Miceuz/PlantWateringAlarm/pics/pile-o-chirps.png

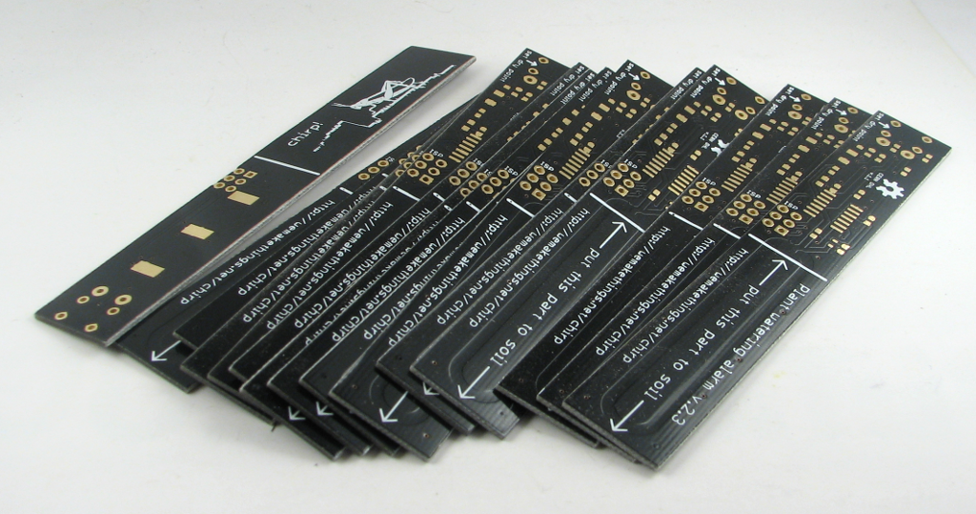
pics/pile-o-chirps.png
