Miceuz/PlantWateringAlarm/pics/IMG_9156.JPG

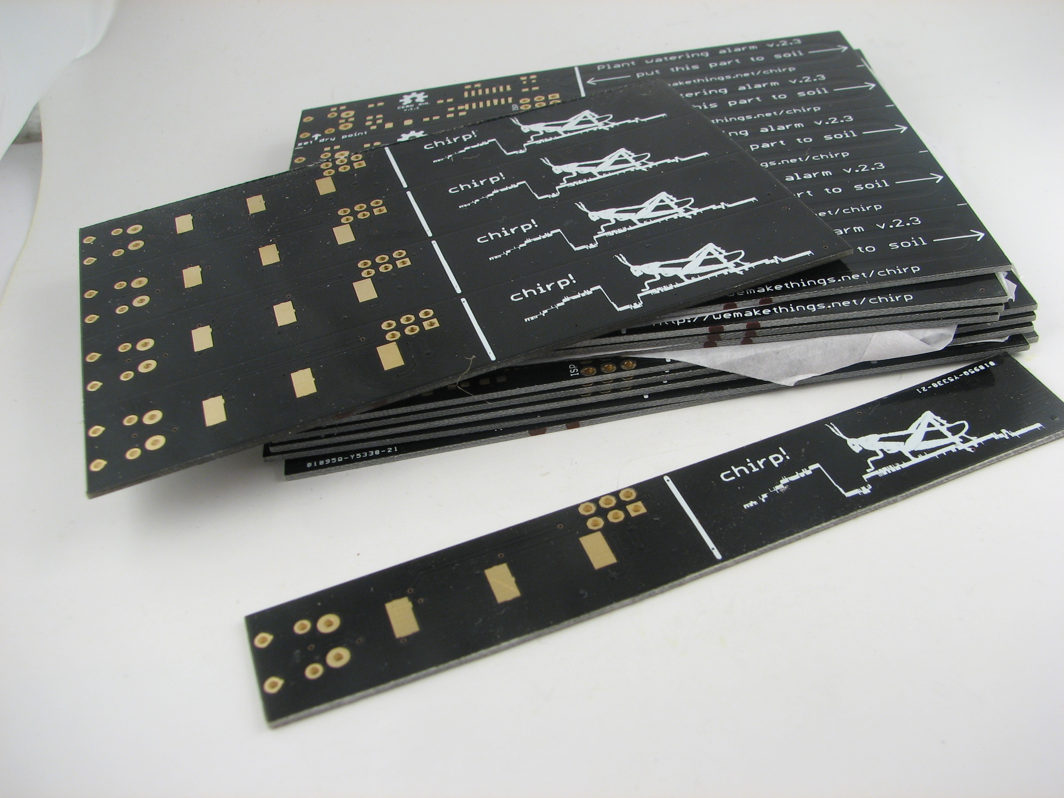
pics/IMG_9156.JPG
