Miceuz/PlantWateringAlarm/README.md

PlantWateringAlarm
==================

A soil moisture level sensor based on ATTINY44. Uses capacitive sensing.



More info at http://wemakethings.net/chirp

Contact: mic a wemakethings.net
