Miceuz/PlantWateringAlarm/chirp-mfg-2.4.4/chirp-schematics.png

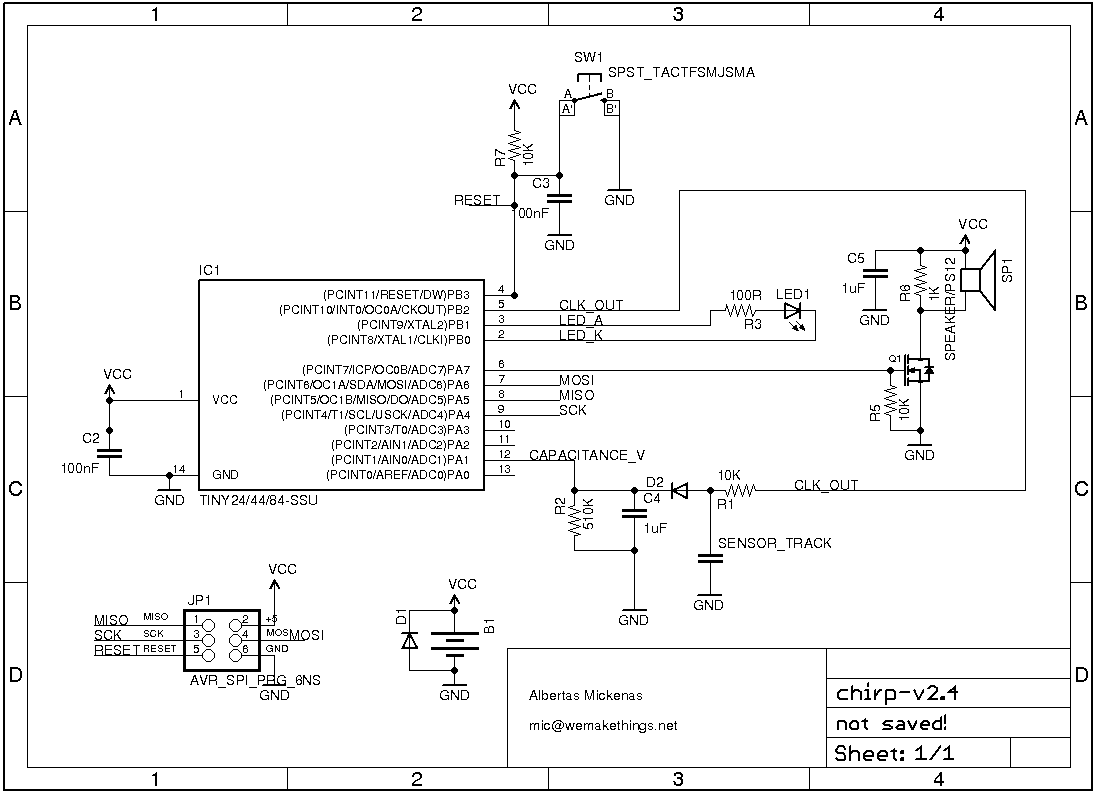
chirp-mfg-2.4.4/chirp-schematics.png
