Miceuz/PlantWateringAlarm/chirp-mfg-2.4.4/chirp-top.jpg

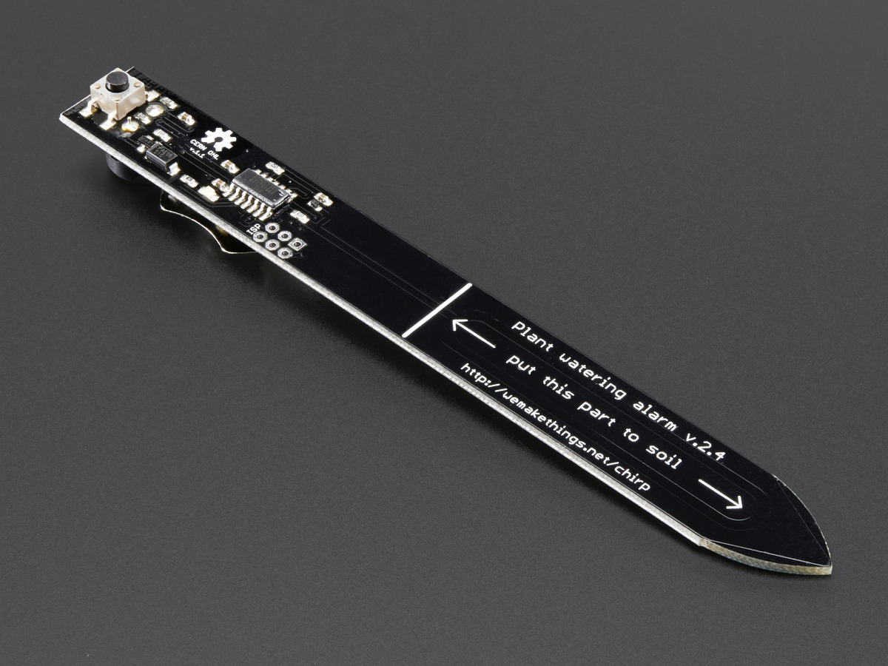
chirp-mfg-2.4.4/chirp-top.jpg
