Miceuz/PlantWateringAlarm/eagleUp/chirp-bot.png

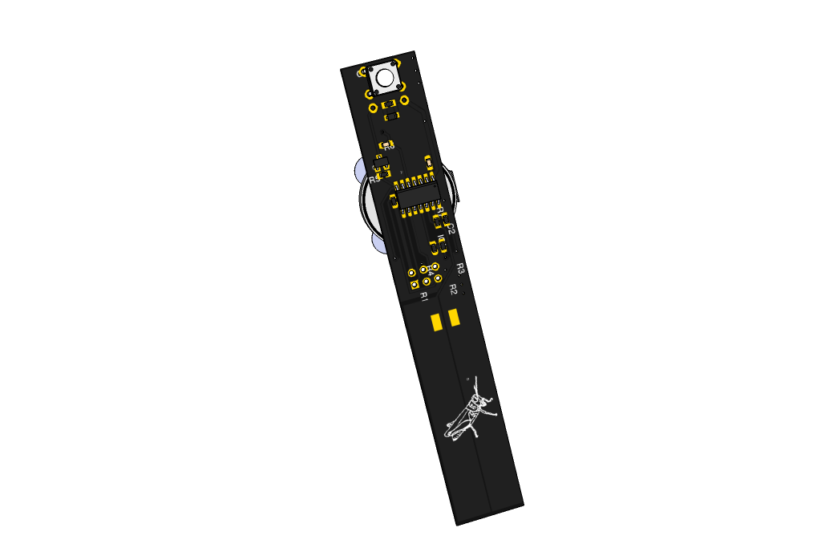
eagleUp/chirp-bot.png
