Miceuz/PlantWateringAlarm/eagleUp/chirp.png

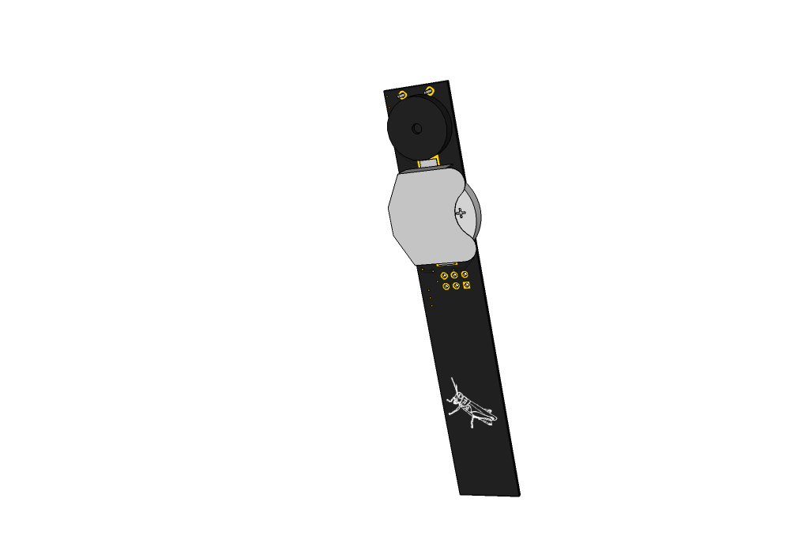
eagleUp/chirp.png
