Miceuz/PlantWateringAlarm/eagleUp/eagleUp_humidity-v2.1_bottom.png

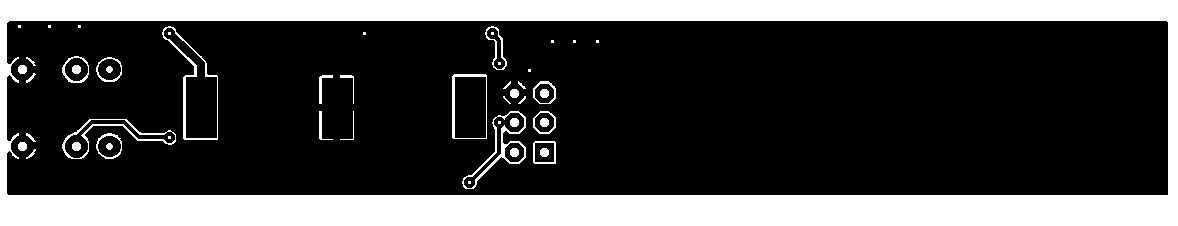
eagleUp/eagleUp_humidity-v2.1_bottom.png
