Miceuz/PlantWateringAlarm/eagleUp/eagleUp_humidity-v2.1_bottom_mask.png

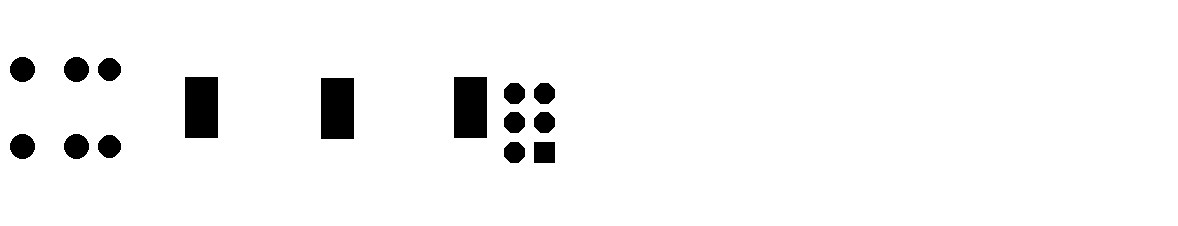
eagleUp/eagleUp_humidity-v2.1_bottom_mask.png
