Miceuz/PlantWateringAlarm/eagleUp/eagleUp_humidity-v2.1_bottom_silk.png

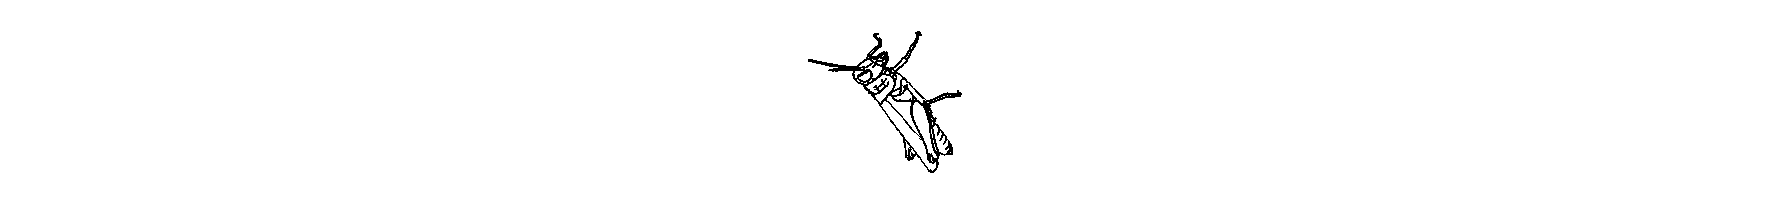
eagleUp/eagleUp_humidity-v2.1_bottom_silk.png
