Miceuz/PlantWateringAlarm/eagleUp/eagleUp_humidity-v2.1_imagesize.png

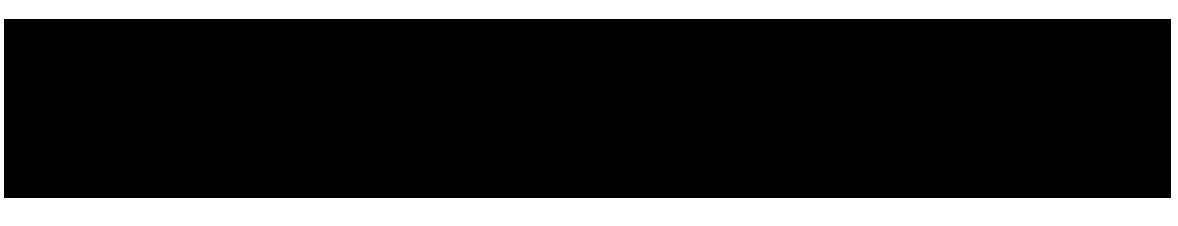
eagleUp/eagleUp_humidity-v2.1_imagesize.png
