Miceuz/PlantWateringAlarm/eagleUp/eagleUp_humidity-v2.1_outline.png

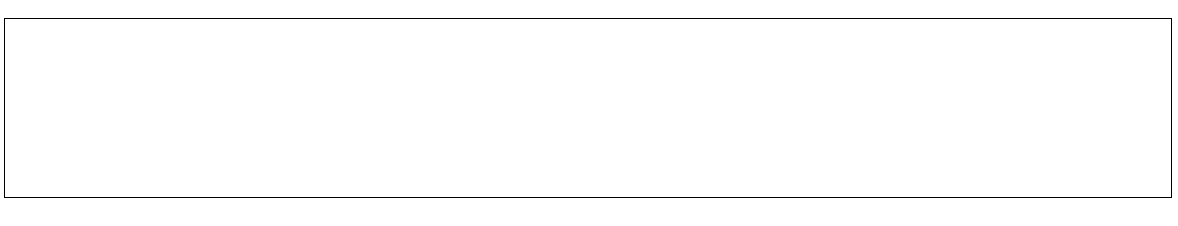
eagleUp/eagleUp_humidity-v2.1_outline.png
