Miceuz/PlantWateringAlarm/eagleUp/eagleUp_humidity-v2.1_top.png

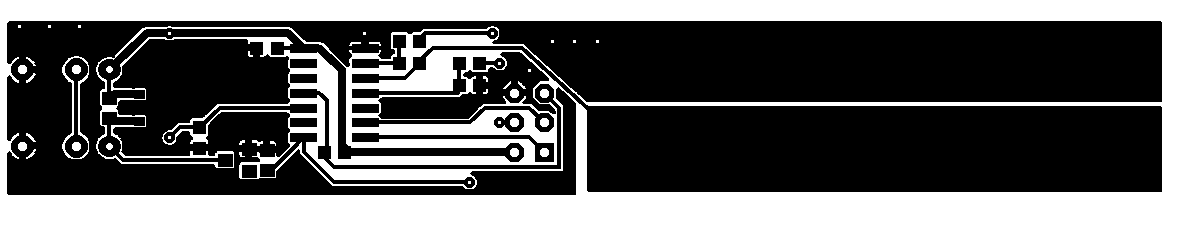
eagleUp/eagleUp_humidity-v2.1_top.png
