Miceuz/PlantWateringAlarm/eagleUp/eagleUp_humidity-v2.1_top_mask.png

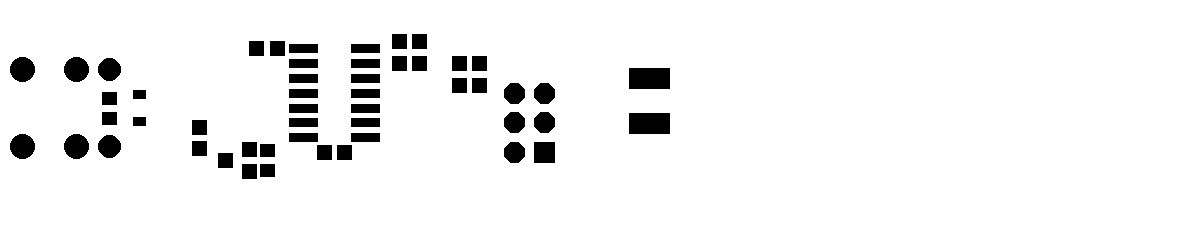
eagleUp/eagleUp_humidity-v2.1_top_mask.png
