Miceuz/PlantWateringAlarm/eagleUp/eagleUp_humidity-v2.1_top_silk.png

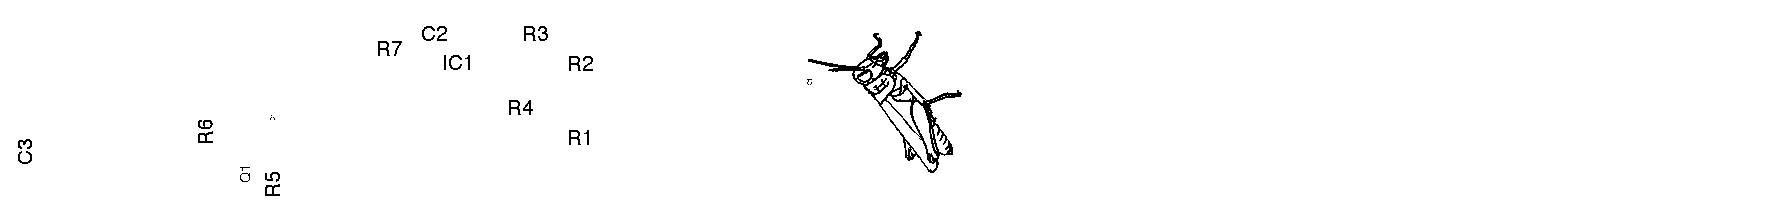
eagleUp/eagleUp_humidity-v2.1_top_silk.png
