Miceuz/PlantWateringAlarm/eagleUp/eagleUp_humidity-v2.3_bottom.png

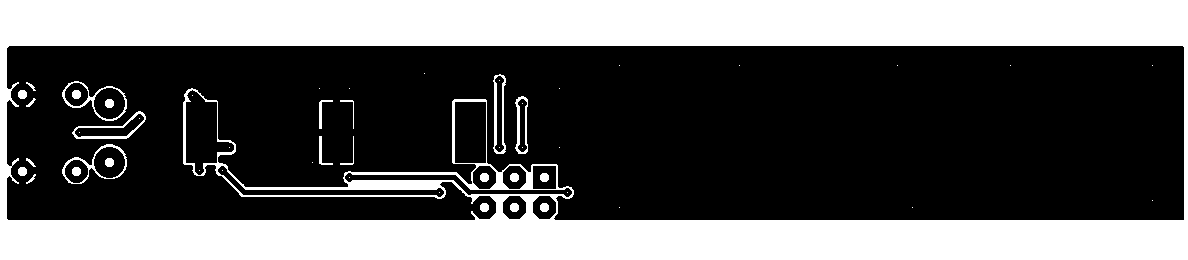
eagleUp/eagleUp_humidity-v2.3_bottom.png
