Miceuz/PlantWateringAlarm/eagleUp/eagleUp_humidity-v2.3_bottom_mask.png

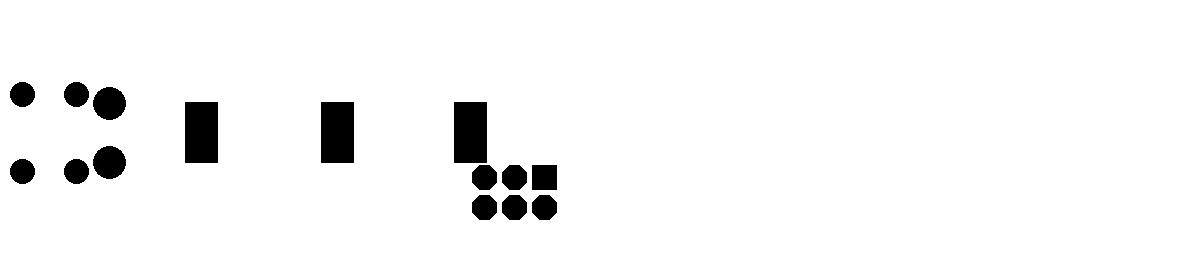
eagleUp/eagleUp_humidity-v2.3_bottom_mask.png
