Miceuz/PlantWateringAlarm/eagleUp/eagleUp_humidity-v2.3_bottom_silk.png

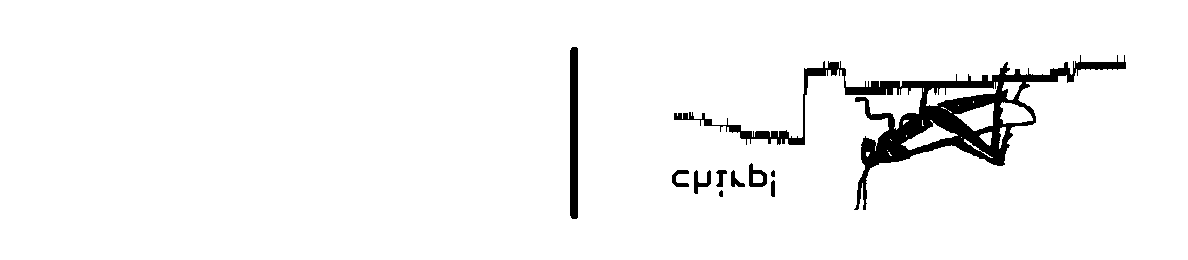
eagleUp/eagleUp_humidity-v2.3_bottom_silk.png
