Miceuz/PlantWateringAlarm/eagleUp/eagleUp_humidity-v2.3_top.png

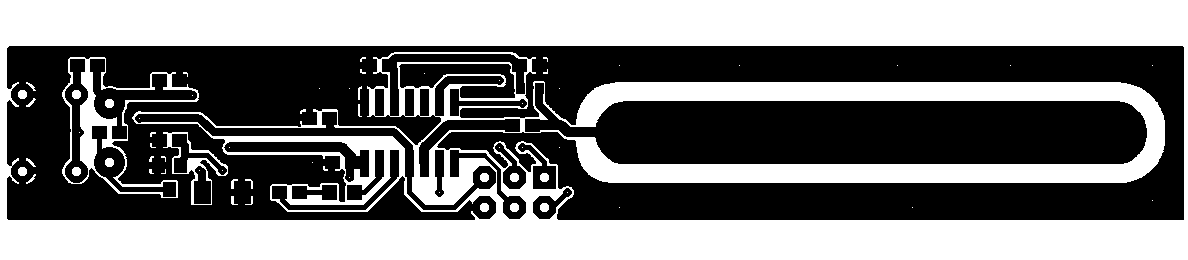
eagleUp/eagleUp_humidity-v2.3_top.png
