Miceuz/PlantWateringAlarm/eagleUp/eagleUp_humidity-v2.3_top_mask.png

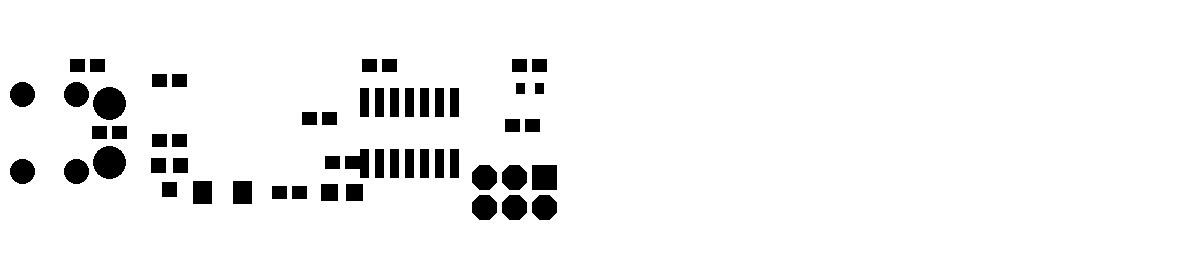
eagleUp/eagleUp_humidity-v2.3_top_mask.png
