Miceuz/PlantWateringAlarm/eagleUp/eagleUp_humidity-v2.3_top_silk.png

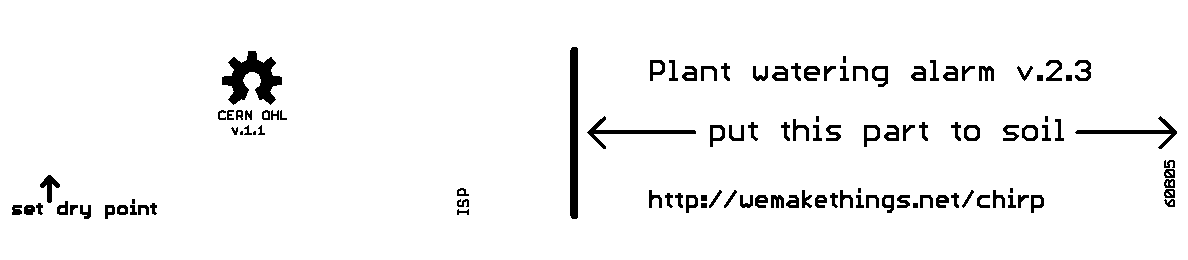
eagleUp/eagleUp_humidity-v2.3_top_silk.png
