Miceuz/PlantWateringAlarm/pics/chirp-boards.jpg

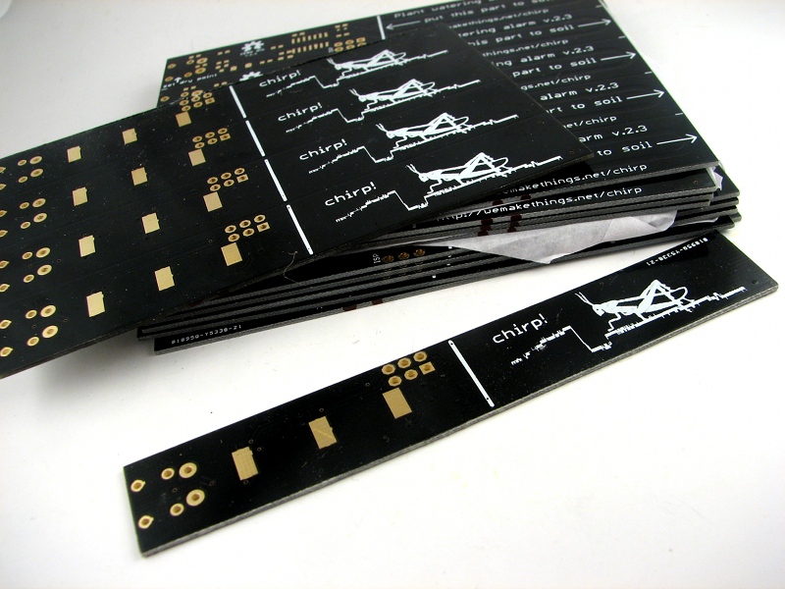
pics/chirp-boards.jpg
