Miceuz/PlantWateringAlarm/pics/IMG_9155.JPG

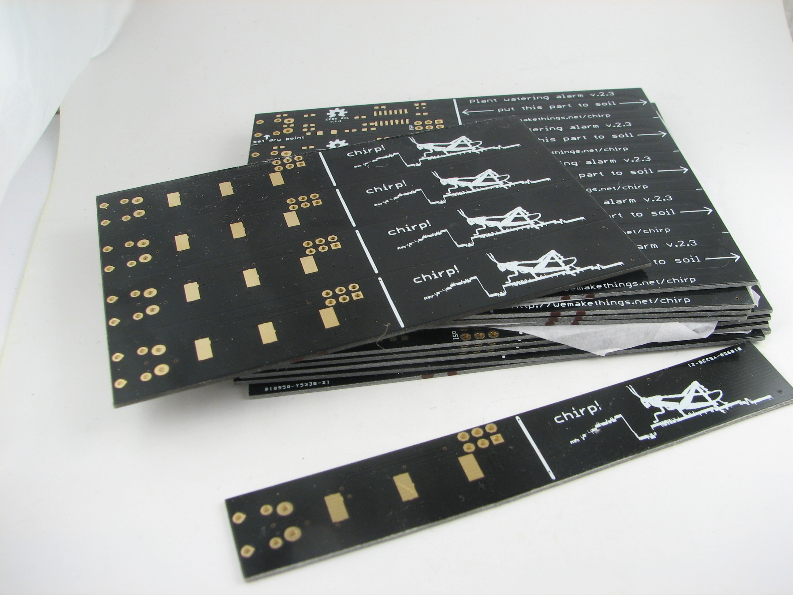
pics/IMG_9155.JPG
