Miceuz/PlantWateringAlarm/pics/IMG_9157.JPG

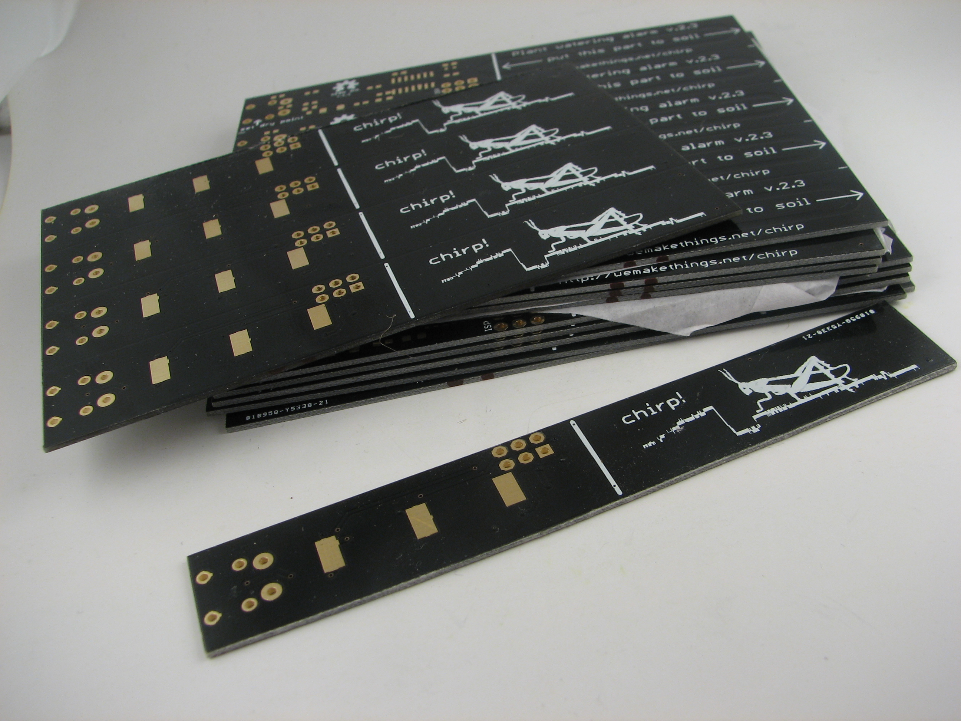
pics/IMG_9157.JPG
