Miceuz/PlantWateringAlarm/pics/sensor.jpg

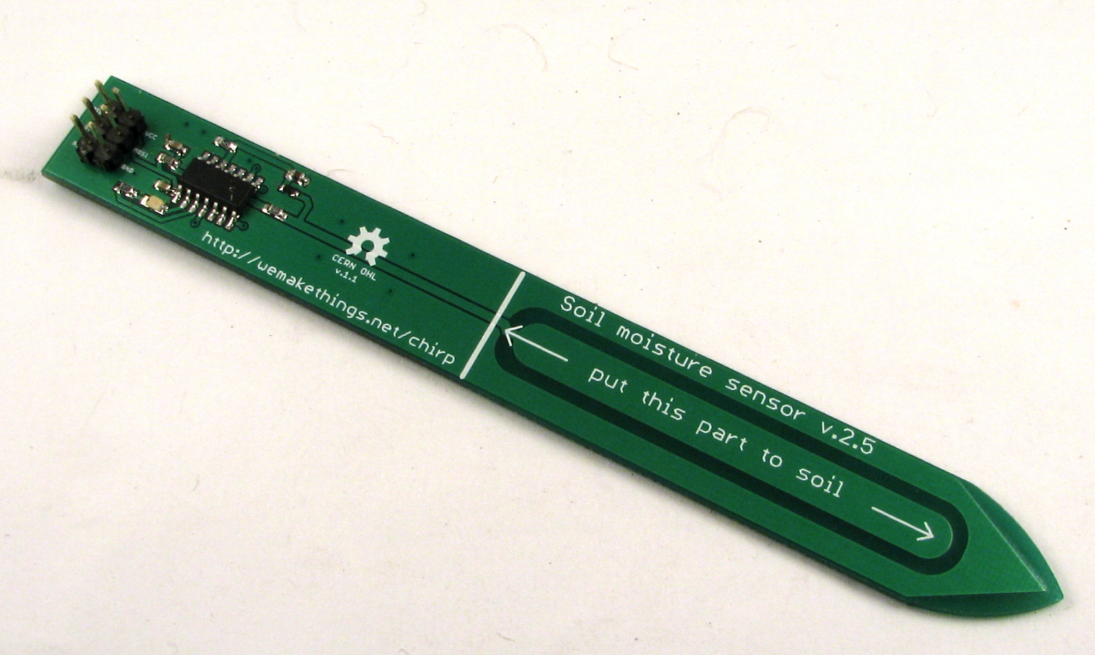
pics/sensor.jpg
