Miceuz/PlantWateringAlarm/(list of files, cad)

Other CAD files:
eagleUp/chirp v.2.3.skp
eagleUp/chirp.skp
eagleUp/chirp2.skp
eagleUp/humidity-v2.3.eup.skp
