Miceuz/PlantWateringAlarm/pics/measurements-moisture.png

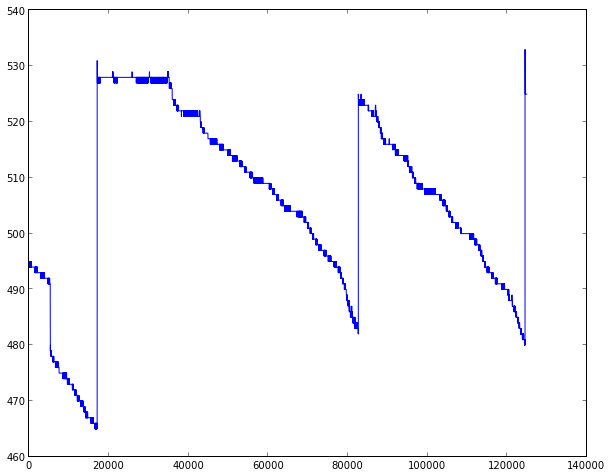
pics/measurements-moisture.png
