Miceuz/PlantWateringAlarm/pics/measurements.png

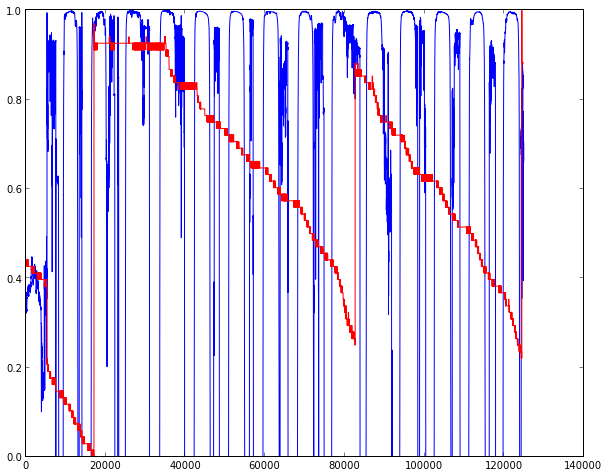
pics/measurements.png
