Miceuz/PlantWateringAlarm/tests/temp-drift.png

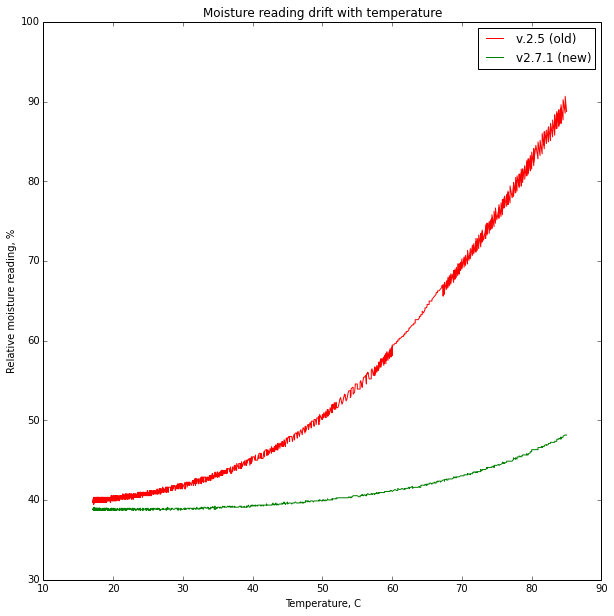
tests/temp-drift.png
