Miceuz/PlantWateringAlarm/(threads)

Thread 1 (2015-04-17):

No Part?

sabas1080, 2015-04-17:
Hi
What numer part is diode schottky, mofet N and "diode sod80c"?

Thanks

sabas1080, 2015-04-17:
I'm sorry and I saw bom.csv, thanks

Closed 2015-04-17.

Thread 3 (2017-02-27):

Operation with lithium cells

dewi-ny-je, 2017-02-27:
Since I have multiple plants next to each other I was thinking about powering them with a rechargeable lithium cell.

Would Chirp work with 4.1-3.3 V input? What is the tested operating range?

Miceuz, 2017-02-27:
Tested operating range is 3.3 to 5V. The circuit is really sensitive to voltage swings, so better add a low drop out regulator to keep it at 3.3V. You can get one in sot-23-5 package with enable pin which you could use to power down all the sensors. Put your I2C pullup resistors on the same regulated 3.3V so that they can get shut down also.

dewi-ny-je, 2017-02-27:
Thanks for the info. I'm buying some MCP1700-3.0 that should have 1.6 uA quiescent current, to keep things simple.

Closed 2020-02-10.

Thread 4 (2017-07-11):

Disable BOD not working

cimba007, 2017-07-11:
> In order to disable BOD during sleep (see Table 7-1 on page 33) the BODS bit must be written to
> logic one. This is controlled by a timed sequence and the enable bit, BODSE in MCUCR. First,both BODS and BODSE must be set to one. Second, within four clock cycles, BODS must be
> set to one and BODSE must be set to zero.

I think the current implementation violates the "4 clock cycle rule". OR ing the bits takes too much time. This results in an power down current consumption of ~27µA (BOD is active if not disabled by fuses).

I propose the following implementation of the sleep function.

```
void inline sleep() {
    set_sleep_mode(SLEEP_MODE_PWR_DOWN);
    sleep_enable();
    //MCUCR |= _BV(BODS) | _BV(BODSE);    //disable brownout detection during sleep
    //MCUCR &=~ _BV(BODSE);
    uint8_t mcucr1 = MCUCR | _BV(BODS) | _BV(BODSE);
    uint8_t mcucr2 = mcucr1 & ~_BV(BODSE);
    MCUCR = mcucr1;
    MCUCR = mcucr2;
    sleep_cpu();
    sleep_disable();
}
```

There might still be room for improvement (https://github.com/LowPowerLab/LowPower/blob/master/LowPower.cpp#L41) but this solution works for me.

Now my chirp consumes only 6µA instead of 27µA during power down.

Miceuz, 2017-07-12:
Thank you for the catch! I will address it in my next batch.

Miceuz, 2017-07-12:
Now when I think about this more - disabling BOD might be a bad idea resulting in a corrupted flash, don't you think?

cimba007, 2017-07-12:
During active operation more current will be consumed resulting in a potentially lower voltage of the coin cell. Disabling BOD during sleep (a period with low current consumption) should always result in a higher battery voltage.

So disabling BOD during sleep should be safe. After sleep wakeup BOD will be enabled and if the voltage is too low should result in a reset condition.

The only think you should thing about is why the CPU is fused to 8mhz as it ius not save for 3V, better run all the time with 1mhz which allows 1,8Volt of operational current.

cimba007, 2017-07-12:
One addition:

    _delay_ms(1);
    getADC1();
    _delay_ms(1000);

WIll take 4 Seconds instead of the intended 1 second. Can you tell me more about the reason for this delay? I guess you ran some test ;-)

Thread 5 (2017-07-12):

Messing with Timer0 will break Arduino millis(), micros() and delay(), delaymicroseconds()

cimba007, 2017-07-12:
I propose the state of timer0 is restored after messing with it. I hooked up a NRF24L01+ module which unfortunatly needs the delay function to work properly.

My workaround is a little bit crude:

```
uint8_t save1;
uint8_t save2;
uint8_t save3;

void setup (void) {
    save1 = OCR0A;
    save2 = TCCR0A;
    save3 = TCCR0B;
```

```
    // Restore mess made by capacitance measurement
    PRR &= ~_BV(PRTIM0);
    OCR0A = save1;
    TCCR0B = save3;
    TCCR0A = save2;
```

Closed 2020-02-10.

Thread 6 (2017-08-20):

Problem Interfacing with Raspberry Pi Over I2C

dpassarella, 2017-08-20:
Hi, I am having trouble getting anything useful from the Chirp! over I2C.

I am having trouble interfacing with it on both the raspberry pi and arduino.  I soldered on some headers and tried to connect it to the raspberry pi.  I did the following steps

Chirp! -> PI
VCC -> 3.3V
GND -> GND
SDA -> SDA1
SCK -> SCK1
Pin 1 -> Left unwired
Pin 5 - Left unwired

I am using the following code from your github readme

import smbus, time, sys

class Chirp:
	def __init__(self, bus=1, address=0x20):
		self.bus_num = bus
		self.bus = smbus.SMBus(bus)
		self.address = address

	def get_reg(self, reg):
		# read 2 bytes from register
		val = self.bus.read_word_data(self.address, reg)
		# return swapped bytes (they come in wrong order)
		return (val >> 8) + ((val & 0xFF) << 8)

	def reset(self):
		# To reset the sensor, write 6 to the device I2C address
		self.bus.write_byte(self.address, 6)

	def set_addr(self, new_addr):
		# To change the I2C address of the sensor, write a new address
		# (one byte [1..127]) to register 1; the new address will take effect after reset
		self.bus.write_byte_data(self.address, 1, new_addr)
		self.reset()
		self.address = new_addr

	def moist(self):
		# To read soil moisture, read 2 bytes from register 0
		return self.get_reg(0)

	def temp(self):
		# To read temperature, read 2 bytes from register 5
		return self.get_reg(5)

	def light(self):
		# To read light level, start measurement by writing 3 to the
		# device I2C address, wait for 3 seconds, read 2 bytes from register 4
		self.bus.write_byte(self.address, 3)
		time.sleep(1.5)
		return self.get_reg(4)

	def __repr__(self):
		return "<Chirp sensor on bus %d, addr %d>" % (self.bus_num, self.address)

if __name__ == "__main__":
	addr = 0x20
	if len(sys.argv) == 2:
		if sys.argv[1].startswith("0x"):
			addr = int(sys.argv[1], 16)
		else:
			addr = int(sys.argv[1])
	chirp = Chirp(1, addr)

	print chirp
	print "Moisture\tTemperature\tBrightness"
	while True:
		print "%d\t%d\t%d" % (chirp.moist(), chirp.temp(), chirp.light())
		time.sleep(1)

At first, I would get:

<Chirp sensor on bus 1, addr 32>
Moisture	Temperature	Brightness
Traceback (most recent call last):
  File "chirp.py", line 57, in <module>
    print "%d\t%d\t%d" % (chirp.moist(), chirp.temp(), chirp.light())
  File "chirp.py", line 29, in moist
    return self.get_reg(0)
  File "chirp.py", line 12, in get_reg
    val = self.bus.read_word_data(self.address, reg)
IOError: [Errno 121] Remote I/O error

Then, I hit the button on the chirp right before I ran the code and started getting this

pi@raspberrypi:~ $ python chirp.py
<Chirp sensor on bus 1, addr 32>
Moisture	Temperature	Brightness
65535	65535	65535
65535	65535	65535

I have checked the reviews and the open issues on the Arduino library from Apollon77 and I even tried adding a 10K pullup on both i2c lines and still get similar results.  The only time it seems to work is the first time it runs on arduno code, but then goes back to 65535 readings.

Do you think this is a hardware issue?  Do you have any guidance?  I have tried this with 2 Chirp!'s and still the same thing.

Miceuz, 2017-08-23:
You have to control the reset line of the Chirp - reset it, then send any I2C command to it so it stays in sensor mode. Look this Arduino example for reference: https://gist.github.com/Miceuz/8ace1cde27671e8e161d

Also you have to slow down the raspi i2c clock speed drastically. It's due to raspi not dealing with i2c clock stretching properly.

Closed 2017-08-23.

Thread 7 (2018-01-19):

Are External I2C Pullup Resistors Required?

vicatcu, 2018-01-19:
Hey, sorry this is not really an issue per say, except maybe a documentation issue. Are external pull-up resistors required if you are using the stand-alone sensor version to interface with an Arduino over I2C?

I don't see any in the schematics, but maybe I missed something. If indeed they aren't there, might not be a horrible idea to put pads on the PCB to (optionally) populate them.

Miceuz, 2018-01-19:
Idea being that there could be other devices on the bus and bus design is a higher level task, I think master should provide pullups. Say, its totally a designer decision on the size of pullup resistors.

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

--
Sent from my Android device with K-9 Mail. Please excuse my brevity.

vicatcu, 2018-01-19:
Yup, I dig it, and I agree in general. The question is really can you hook it up (as the only device on the I2C bus) to an Arduino Uno directly and communicate successfully? For example using [this library](https://github.com/Apollon77/I2CSoilMoistureSensor) or the example code on [your page](https://wemakethings.net/chirp/). It wouldn't hurt to put a reminder to developers that these external resistors _might_ be necessary in a given application.

Miceuz, 2018-01-19:
Yes, you can hook it up directly to Arduino. Their internal pullups by default are on and are enough to test.

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

--
Sent from my Android device with K-9 Mail. Please excuse my brevity.

Closed 2020-02-10.

Thread 8 (2018-05-30):

i2c power usage

luismanson, 2018-05-30:
Hello, thanks for this device and your time, I plan on read this from an esp board, can i keep the coin cell? I do not know how much will it last.
Also, i plan on having more than one device on the bus, how do i change the addess?

thanks :)

Miceuz, 2018-05-31:
Hi,

For bigger installations consider the sensor-only version, either I2C or RS485.
https://github.com/Miceuz/i2c-moisture-sensor
https://github.com/Miceuz/rs485-moist-sensor

Closed 2018-05-31.

Thread 9 (2019-02-16):

Discharge through transistors

mundodisco8, 2019-02-16:
Hi,
I've read your writeup about using transistors to discharge C1 faster, but on the latest version I can find in your repo, I see no trace of those trasnsistors. Have you moved to a simpler design? If so, can you explain why?

Thanks for sharing your project!

Miceuz, 2020-02-10:
Hi,

Transistors worked in simulation, but are too slow when run at high frequency. Besides, it works fine enough.

Closed 2020-02-10.

Thread 10 (2019-02-23):

I2C addresses > 127 are invalid

timcharper, 2019-02-23:
I2C addresses are 7bits; the 8th bit is reserved for the protocol to indicate whether a read or a write is intended. If one accidentally writes an invalid address, then it "bricks" the device as a sensor, and one must use an avr programmer to manipulate eeprom manually or erase the contents and reprogram.

https://www.totalphase.com/support/articles/200349176-7-bit-8-bit-and-10-bit-I2C-Slave-Addressing

https://learn.adafruit.com/i2c-addresses/overview

timcharper, 2019-02-25:
I think several of the first couple of addresses are reserved, also. On page 17 of https://www.nxp.com/docs/en/user-guide/UM10204.pdf they're detailed. So address must be in the range [8..123]

Closed 2020-02-10.

Thread 12 (2019-05-04):

Switch of read out registers when resetting

itofficeeu, 2019-05-04:
When I have the sensor hocked up to I2C and I use the reset on the top of the sensor, can it happen that the read out registers switches. Moisture then is read from the register for light and the other way around.

I do not know if this depends on the producer. I do not now if this can be fixed by software. I can reveal that my hardware does not respond with temperature data. So maybe is it only the product I have in hand? - Be aware from where you buy, if the temperature sensing is important. Try out a small quantity first.

One should be prepared for sanitizing the switched data afterwards or maybe even build in an automatic sanitation.

The moisture values runs from around 300 to close to 500 (covered by hand). The light values from zero when full lid by for instance a flashlight, to close to 9000 when I cover it with my one hand (could maybe be more when absolute dark is reached?). - I do not know if these figures are different on hardware from other producers.

DrBabbage, 2022-07-18:
I might have the same issue. Have you found a fix?

itofficeeu, 2022-07-18:
Nope. Dropped working with the sensor.

Miceuz, 2022-07-19:
Chirp is not ment for proper installations, just play around with a pot nearby. For proper performance look into standalone I2C sensor

Closed 2022-12-15.

Thread 13 (2019-06-09):

Sensor damaged by soil

git-torrent, 2019-06-09:
Hello,

my sensor got damaged by soil (paint peeled off). Readings go from 200 to 2000, I can't use it anymore. I guess the paint reacts with sourer soil.
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
Thank you

Miceuz, 2019-06-10:
Hello,

Can you please give more information:
 * What is the version written on the sensor?
 * How long did it take before failure?

Miceuz, 2019-06-10:
Also can you plese make a picture of the damage on the other side of the sensor?

git-torrent, 2019-06-12:
Hello, for sure I am sending both sides. In two separate emails

[image: 20190611_195831.jpg]
All the best

Pavol Ostertag

po 10. 6. 2019 v 13:57 odesílatel Albertas Mickėnas <
notifications@github.com> napsal:

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

git-torrent, 2019-06-12:
I am sending both sides, for sure.
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

Miceuz, 2019-06-12:
How long did it take before failure?
And can you please elaborate if the sensor was re-inserted into soil a lot?

git-torrent, 2019-06-12:
The sensor was inserted into soil in October 2018. Back then, values were ca 420 for freshly watered soil and ca 160 for dry soil (I pulled the sensor out). So I calibrated it to range 150 - 400. During winter the sensor remained in the soil. When I started watering again (in March), the readings were always 100% - fully wet. Only when heats started and soil became dry, I started to wonder why the sensor still reads "fully wet". That was the first time I pulled it out. I cleaned the soil from the tip and the result is in the pictures.

The soil is for blackcurrant so it is maybe little bit acidic (Ph6) when fertilized.

Miceuz, 2019-06-14:
Hi,
Thank you for your report. Yes, sensors are not totally bullet proof. Especially when it comes to freezing ground. Can you ship me the sensor for examination? I would ship you a replacement. Please contact me via email - mic at wemakethings dot net

Closed 2020-02-10.

Thread 14 (2019-07-22):

Is it possible to use 2 or more sensors in only 1 i2c bus?

thedonalddon, 2019-07-22:
I have three plants, and I bought 3 sensors for each of them. I'm using an ESP8266 as I2C master and a Raspberry Pi as the controller.
But on ESP8266 I could use only 2 GPIOs as SCL and SDA. Is it possible to connect 3 chirps at the same time using the same i2c bus?
(sorry the question might be silly, I'm kind of rookie about this..)

Miceuz, 2019-07-22:
You can hook up several sensors on the same SCL, SDA lines. Before doing that you have to hook up a single sensor to the bus one by one and set different addresses for each sensor. Don't forget to add pullup resistors if they are not on the esp8266 board yet.

Also if you experience communication stability problems, try lowering pullup values and/or communication speed.

Also it seems you could use a basic tutorial on I2C bus - Sparkfun has a pretty good one that's easy to find.

thedonalddon, 2019-07-23:
The tutorial is really helpful! Should've read it earlier. Thanks!

Closed 2019-07-22.

Thread 15 (2019-08-17):

How to change default I2C Address?

meingraham, 2019-08-17:
The default I<sup>2</sup>C address is 0x20. where on the device does one change this default? By what method?

Thank you!

Miceuz, 2019-08-17:
There is an  I2C register that you write a new address to: 0x01. I.e. you send two bytes to address 0x20: 0x01 and a new address. The new address takes effect after reset.

Closed 2019-08-17.

Thread 16 (2019-09-29):

Do recent sensors ship with the firmware from this repo?

Staars, 2019-09-29:
Hello,

I somehow bricked the I2C-communication to my sensor, probably in the process of assigning a new address, and before I try to reflash it, I want to ask the question above.

The version in /src is 2 years old and does not contain a version number. Besides it still does not include this PR: https://github.com/Miceuz/PlantWateringAlarm/pull/11

Thanks a lot and best regards

Christian

tmm1, 2020-02-08:
Did you end up reflashing to fix i2c?

Staars, 2020-02-08:
Yes and it fixed the problem.
Sidenote: I had bought 2 cheap chinese replicas dead-on-arrival and could bring one to life by flashing it.

Miceuz, 2020-02-10:
Sensors are shipped with the firmware from branch board-update-2.4.5
In general, all chirps I sell are HW version 2.4.5 with the updated firmware. Regarding clones form Aliexpress - I have no idea and no control over it.

Closed 2020-02-10.

Thread 17 (2021-12-14):

re-programming

palitu, 2021-12-14:
I wanted to re-flash the chirp, to learn a bit more about how this all works.

I have looked through the repo, and as far as i can tell the standalone code lives in `PlantWateringAlarm/src/` and to compile and upload to the device, i simply run `sudo make program`.

this will compile the code, set the fuses and upload the firmware.

I am not 100% sure on what is in the programmer directory, but i assume it is to use a microcontroller as programmer for ISP headers?

Can someone confirm this?

cheers

Miceuz, 2021-12-14:
Hi there,

Programmer directory contains files for programming jig I used to use at some point in time, it has no relevance for the project itself nowadays. I should add a readme file there.

DrBabbage, 2022-07-18:
`apt-get install gcc-avr avr-libc -y`

then

`make hex`

DrBabbage, 2022-07-18:
have you managed to get it working?

Miceuz, 2022-07-19:
Run `make hex` to compile the firmware. Run `make fuse` to flash fuses. Run `make flash` to flash the firmware. You need `avrdude` and `USBasp` programmer device to flash out of the box. You can use arduino board as an ISP programmer, but you will have to update `makefile` to make it work.

Closed 2022-07-19.

Thread 19 (2022-07-18):

Fluctuating Sensor data on Raspberry Pi on standalone and chirp

DrBabbage, 2022-07-18:
I use both sensors hooked up individually to a raspberry pi without pull up resistor on a 2 meter cable.
Its a desperate efford to get this soil moisture sensor working with mycodo.

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

The readout is fluctuating between a around 6000 to 240 to 0. Atm its in the soil.

Here is the data communication with the raspberry pi read with a logic analizer.

`W[0x20]·0x2D·W[0x20]·0x29·W[0x20]·0x09·W[0x20]·0x0D·W[0x20]·0x09·W[0x20]·0x29·W[0x20]·0x2D·W[0x20]·0x29·W[0x20]·0x09·W[0x20]·0x0D·W[0x20]·0x09·W[0x20]·0x29·W[0x20]·0x2D·W[0x20]·0x29·W[0x20]·0x09·W[0x20]·0x0D·W[0x20]·0x09·W[0x20]·0x98·W[0x20]·0x9C·W[0x20]·0x98·W[0x20]·0x48·W[0x20]·0x4C·W[0x20]·0x48·W[0x20]·0x29·W[0x20]·0x2D·W[0x20]·0x29·W[0x20]·0x09·W[0x20]·0x0D·W[0x20]·0x09·W[0x20]·0x29·W[0x20]·0x2D·W[0x20]·0x29·W[0x20]·0x09·W[0x20]·0x0D·W[0x20]·0x09·W[0x20]·0x29·W[0x20]·0x2D·W[0x20]·0x29·W[0x20]·0x09·W[0x20]·0x0D·W[0x20]·0x09·W[0x20]·0x29·W[0x20]·0x2D·W[0x20]·0x29·W[0x20]·0x09·W[0x20]·0x0D·W[0x20]·0x09·W[0x20]·0x29·W[0x20]·0x2D·W[0x20]·0x29·W[0x20]·0x09·W[0x20]·0x0D·W[0x20]·0x09·W[0x20]·0x29·W[0x20]·0x2D·W[0x20]·0x29·W[0x20]·0x09·W[0x20]·0x0D·W[0x20]·0x29·W[0x20]·0x2D·W[0x20]·0x29·W[0x20]·0x09·W[0x20]·0x0D·W[0x20]·0x09·W[0x20]·0x29·W[0x20]·0x2D·W[0x20]·0x29·W[0x20]·0x09·W[0x20]·0x0D·W[0x20]·0x09·W[0x20]·0x29·W[0x20]·0x2D·W[0x20]·0x29·W[0x20]·0x09·W[0x20]·0x0D·W[0x20]·0x09·W[0x20]·0x29·W[0x20]·0x2D·W[0x20]·0x29·W[0x20]·0x0D·W[0x20]·0x09·W[0x20]·0x29·W[0x20]·0x2D·W[0x20]·0x29·W[0x20]·0x09·W[0x20]·0x09·W[0x20]·0x29·W[0x20]·0x2D·W[0x20]·0x29·W[0x20]·0x09·W[0x20]·0x0D·W[0x20]·0x09·W[0x20]·0x29·W[0x20]·0x2D·W[0x20]·0x29·W[0x20]·0x09·W[0x20]·0x0D·W[0x20]·0x09·W[0x20]·0x29·W[0x20]·0x2D·W[0x20]·0x29·W[0x20]·0x09·W[0x20]·0x0D·W[0x20]·0x09·W[0x20]·0x29·W[0x20]·0x2D·W[0x20]·0x29·W[0x20]·0x09·W[0x20]·0x0D·W[0x20]·0x09·W[0x20]·0x29·W[0x20]·0x2D·W[0x20]·0x29·W[0x20]·0x09·W[0x20]·0x0D·W[0x20]·0x09·W[0x20]·0x29·W[0x20]·0x2D·W[0x20]·0x29·W[0x20]·0x09·W[0x20]·0x0D·W[0x20]·0x09·W[0x20]·0x29·W[0x20]·0x2D·W[0x20]·0x29·W[0x20]·0x09·W[0x20]·0x0D·W[0x20]·0x09·W[0x20]·0x29·W[0x20]·0x2D·W[0x20]·0x29·W[0x20]·0x09·W[0x20]·0x0D·W[0x20]·0x09·W[0x20]·0x29·W[0x20]·0x2D·W[0x20]·0x29·W[0x20]·0x09·W[0x20]·0x0D·W[0x20]·0x09·W[0x20]·0xD8·W[0x20]·0xDC·W[0x20]·0xD8·W[0x20]·0x48·W[0x20]·0x4C·W[0x20]·0x48·W[0x20]·0x29·W[0x20]·0x2D·W[0x20]·0x29·W[0x20]·0x09·W[0x20]·0x0D·W[0x20]·0x09·W[0x20]·0x29·W[0x20]·0x2D·W[0x20]·0x29·W[0x20]·0x09·W[0x20]·0x0D·W[0x20]·0x09·W[0x20]·0x29·W[0x20]·0x2D·W[0x20]·0x29·W[0x20]·0x09·W[0x20]·0x0D·W[0x20]·0x09·W[0x20]·0x29·W[0x20]·0x2D·W[0x20]·0x29·W[0x20]·0x09·W[0x20]·0x0D·W[0x20]·0x09·W[0x20]·0x29·W[0x20]·0x2D·W[0x20]·0x29·W[0x20]·0x09·W[0x20]·0x0D·W[0x20]·0x09·W[0x20]·0x29·W[0x20]·0x2D·W[0x20]·0x29·W[0x20]·0x09·W[0x20]·0x0D·W[0x20]·0x09·W[0x20]·0x29·W[0x20]·0x2D·W[0x20]·0x29·W[0x20]·0x09·W[0x20]·0x0D·W[0x20]·0x09·W[0x20]·0x29·W[0x20]·0x2D·W[0x20]·0x29·W[0x20]·0x09·W[0x20]·0x0D·W[0x20]·0x09·W[0x20]·0x29·W[0x20]·0x2D·W[0x20]·0x29·W[0x20]·0x09·W[0x20]·0x0D·W[0x20]·0x09...
`
I hooked up a saleae
[soil moisture sensor.zip](https://github.com/Miceuz/PlantWateringAlarm/files/9130918/soil.moisture.sensor.zip)

The chirp I often fail to bring in i2c mode. Is there a trick to do this from the start and skip the whole chirping?

The chirp hw version is 1.1 and the sensor 2.78
I will write some documentation on this.

My sensors are Soil moisture sensor 2.7.8 , 2.7.6 and chirp 2.4

Moisture  | Temp   | Brightness
-------------------------------
38 -39.6% | 0.0°C | 15617
1 -46.9% | 0.0°C | 106
302 12.2% | 31.7°C | 106
304 12.5% | 31.7°C | 106
306 12.9% | 31.7°C | 105
305 12.7% | 31.7°C | 106
306 12.9% | 31.7°C | 105
304 12.5% | 31.6°C | 105
0 -47.1% | 0.0°C | 15616
15617 3015.1% | 1254.5°C | 12801
304 12.5% | 31.7°C | 104

I tried flashing a firmware on one with make hex make program which executed successfully and set the fuses but now it doesn't turn on anymore. I have a second one though.

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

I found some more sensors from you, they also don't work in mycodo so I opened an issue here https://github.com/kizniche/Mycodo/issues/1216 regarding that.

I tried chirp-rpi out and the output is much more stable but it too get these high values from time to time and after some waiting, reading fails completely and i2cdetect takes ages and ultimately fails to detect the sensor.
Also I got rid of the cable so that its now 8cm long.

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

Miceuz, 2022-07-19:
Hi,

2 meters is really stretching it. Things to try

- *use pullups* you can start from 4k7 and try going a bit lower.
- slow down I2C clock
- use shorter cable

Closed 2022-07-19.

Thread 21 (2024-04-19):

firmware old download

adruha, 2024-04-19:
I would like to ask you for the firmware for the old version of the device. Can I download a hex or bin firmware file somewhere? I want to restore the operation of a broken device, thanks in advance!

Closed 2024-04-19.
