Miceuz/PlantWateringAlarm/capsensor/capsensor prints.pdf

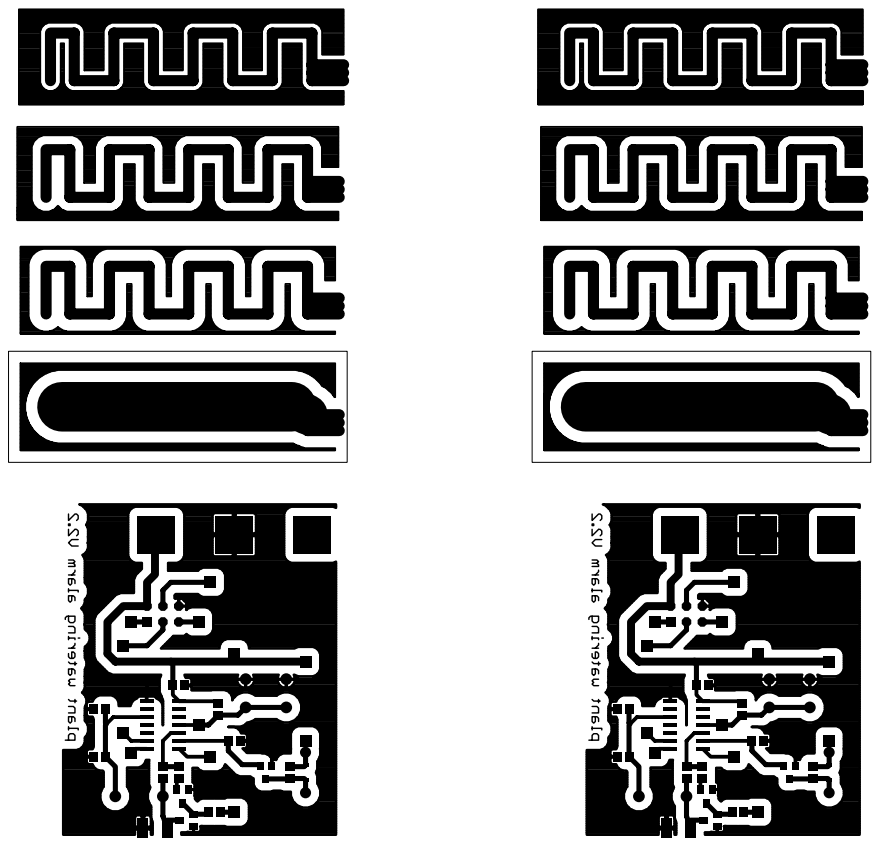
[picture p28: page 1]
