Miceuz/PlantWateringAlarm/capsensor/probes_experiment.pdf

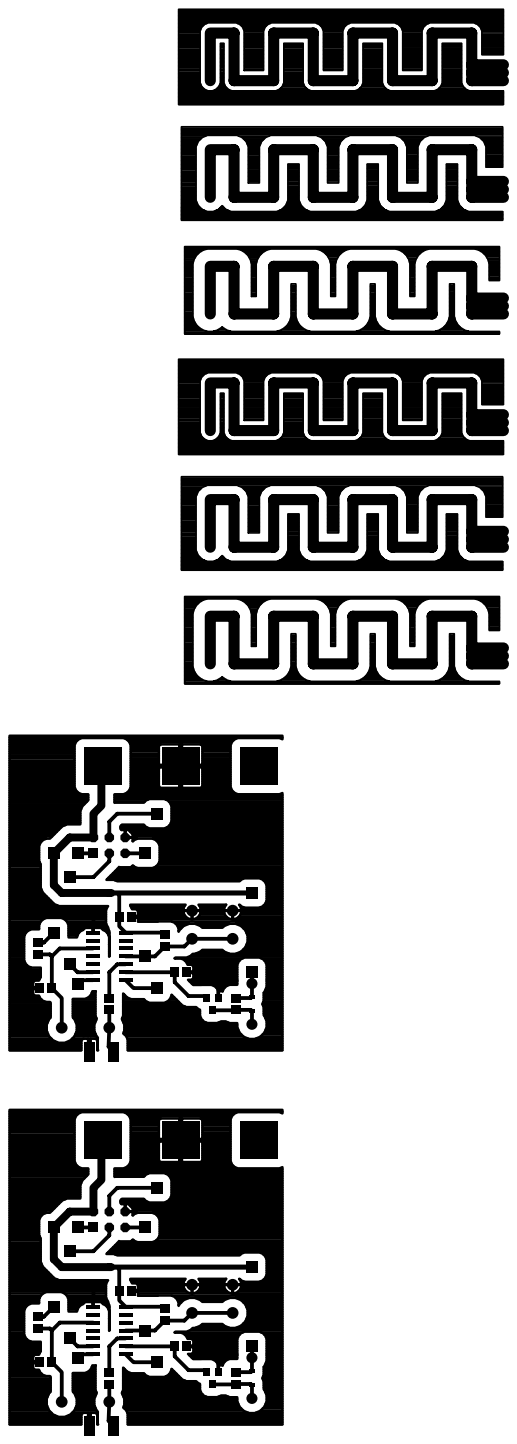
[picture p29: page 1]
