Miceuz/PlantWateringAlarm/humidity-v2.2.pdf

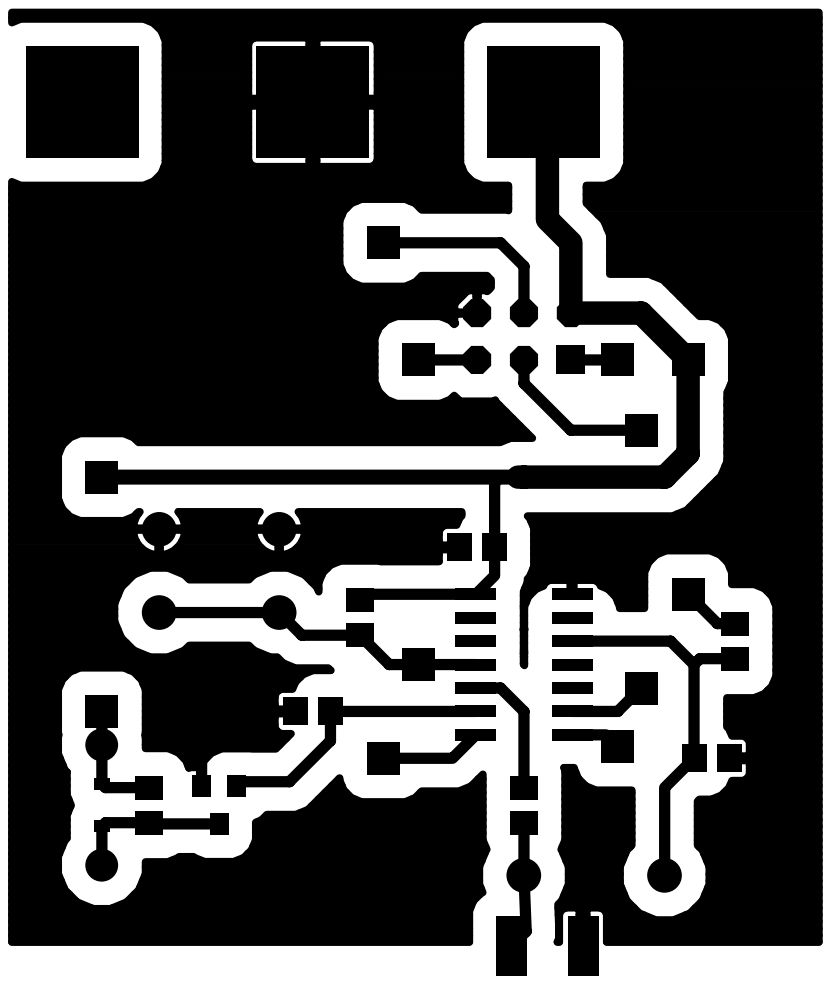
[picture p30: page 1]
