Miceuz/PlantWateringAlarm/chirp-v2.4.kicad_pcb

## KiCad design chirp-v2.4.kicad_pcb (2016-02-23)

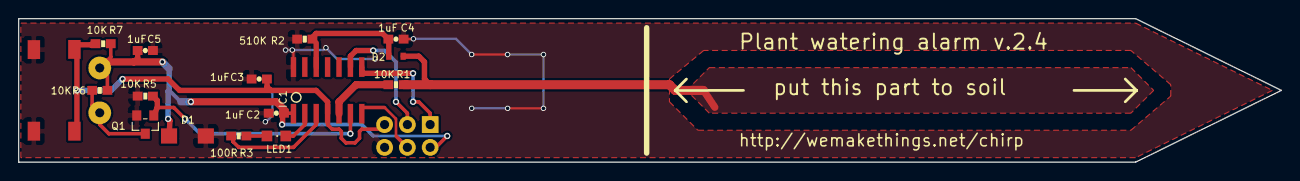
[picture p31: board chirp-v2.4.kicad_pcb from above]

Board: 2 copper layers, 140.8 x 16.0 mm, 19 parts (0 on the bottom side), 14 nets.

Parts:
B1: BAT-HLD-001
C2, C3, C4, C5: 1uF; 0603-CAP
D1: DO214AC
D2: DIODE-SCHOTTKY_; SOD-523
IC1: TINY24/44/84-SSU; SOIC14
JP1: AVR_SPI_PRG_6NS; 2X3-NS
LED1: CHIPLED_0805
Q1: SOT23
R1, R5, R6, R7: 10K; 0603-RES
R2: 510K; 0603-RES
R3: 100R; 0603-RES
SP1: SPEAKER/PS12; PS12
SW1: SPST_TACTFSMJSMA; FSMJSMA

Connections:
BUZZER: IC1.6, Q1.1, R5.2
CAPACITANCE_V: C4.1, D2.K, IC1.12, R2.1
CLK_OUT: IC1.5, R1.2
GND: B1.2, C2.2, C3.2, C4.2, C5.2, D1.A, IC1.14, JP1.6, Q1.2, R2.2, R5.1, SW1.B, SW1.B'
LED_A: IC1.3, R3.2
LED_K: IC1.2, LED1.C
MISO: IC1.8, JP1.1
MOSI: IC1.7, JP1.4
unnamed: Q1.3, R6.1, SP1.P$2
unnamed: LED1.A, R3.1
RESET: C3.1, IC1.4, JP1.5, R7.1, SW1.A, SW1.A'
SCK: IC1.9, JP1.3
VCC: B1.1, C2.1, C5.1, D1.C, IC1.1, JP1.2, R6.2, R7.2, SP1.P$1
V_CAP: D2.A, R1.1
