Miceuz/PlantWateringAlarm/chirp-v2.4.brd

## EAGLE design chirp-v2.4.brd (2015-12-13)

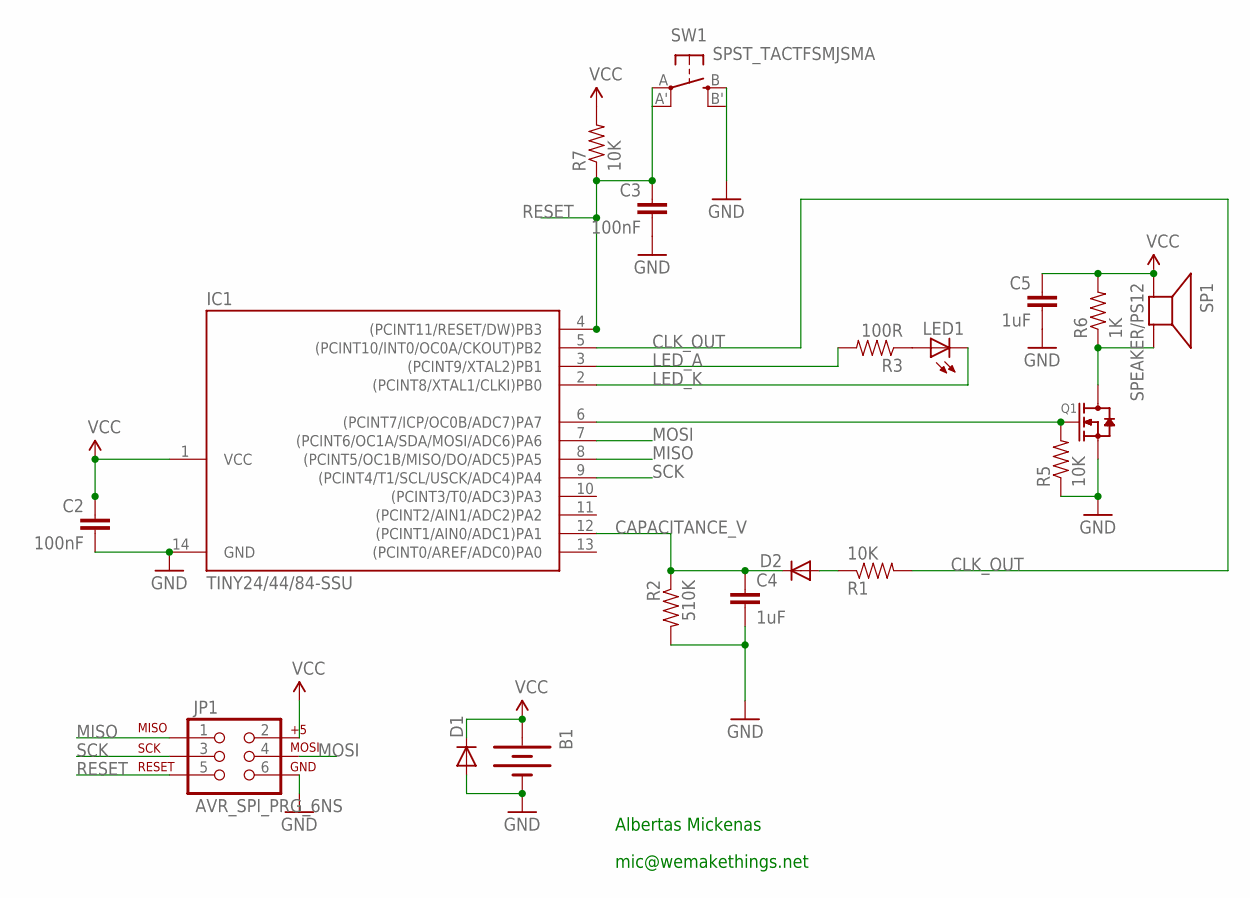
[picture p32: schematic chirp-v2.4.sch, Plant watering alarm v2.4]

Parts:
B1: BATTERY; BAT-HLD-001
C2, C3: 100nF; 0603-CAP
C4, C5: 1uF; 0603-CAP
D1: DIODE-DO214AC; DO214AC
D2: DIODE-SCHOTTKY_; SOD-523
IC1: TINY24/44/84-SSU; SOIC14
JP1: AVR_SPI_PRG_6NS; 2X3-NS
LED1: LEDCHIPLED_0805; CHIPLED_0805
Q1: MOSFET-N-SOT23; SOT23
R1, R5, R7: 10K; 0603-RES
R2: 510K; 0603-RES
R3: 100R; 0603-RES
R6: 1K; 0603-RES
SP1: SPEAKER/PS12; PS12
SW1: SPST_TACTFSMJSMA; FSMJSMA

Connections:
BUZZER: IC1.6 ((PCINT7/ICP/OC0B/ADC7)PA7), Q1.1 (G), R5.2
CAPACITANCE_V: C4.1, D2.K (C), IC1.12 ((PCINT1/AIN0/ADC1)PA1), R2.1
CLK_OUT: IC1.5 ((PCINT10/INT0/OC0A/CKOUT)PB2), R1.2
GND: B1.2 (-), C2.2, C3.2, C4.2, C5.2, D1.A, IC1.14 (GND), JP1.6, Q1.2 (S), R2.2, R5.1, SW1.B (S), SW1.B' (S1)
LED_A: IC1.3 ((PCINT9/XTAL2)PB1), R3.2
LED_K: IC1.2 ((PCINT8/XTAL1/CLKI)PB0), LED1.C
MISO: IC1.8 ((PCINT5/OC1B/MISO/DO/ADC5)PA5), JP1.1
MOSI: IC1.7 ((PCINT6/OC1A/SDA/MOSI/ADC6)PA6), JP1.4
unnamed: Q1.3 (D), R6.1, SP1.P$2 (-)
unnamed: LED1.A, R3.1
RESET: C3.1, IC1.4 ((PCINT11/RESET/DW)PB3), JP1.5, R7.1, SW1.A, SW1.A' (P1)
SCK: IC1.9 ((PCINT4/T1/SCL/USCK/ADC4)PA4), JP1.3
VCC: B1.1 (+), C2.1, C5.1, D1.C, IC1.1 (VCC), JP1.2, R6.2, R7.2, SP1.P$1 (+)
V_CAP: D2.A, R1.1

Notes on the sheet:
Albertas Mickenas
mic@wemakethings.net

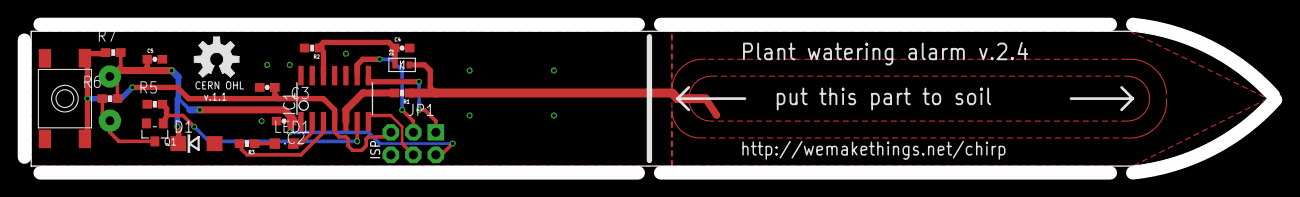
[picture p33: board chirp-v2.4.brd from above]

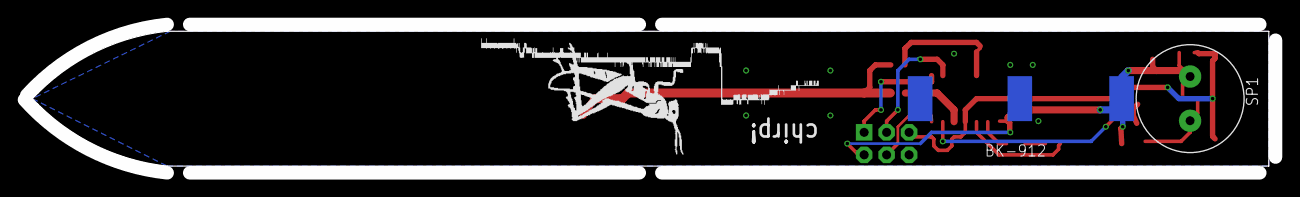
[picture p34: board chirp-v2.4.brd from below]

Board: 2 copper layers, 141.4 x 16.8 mm, 19 parts (2 on the bottom side), 14 nets.
