Miceuz/PlantWateringAlarm/gerbers/humidity-v2.4 panel.brd

## EAGLE design gerbers/humidity-v2.4 panel.brd (2014-02-17)

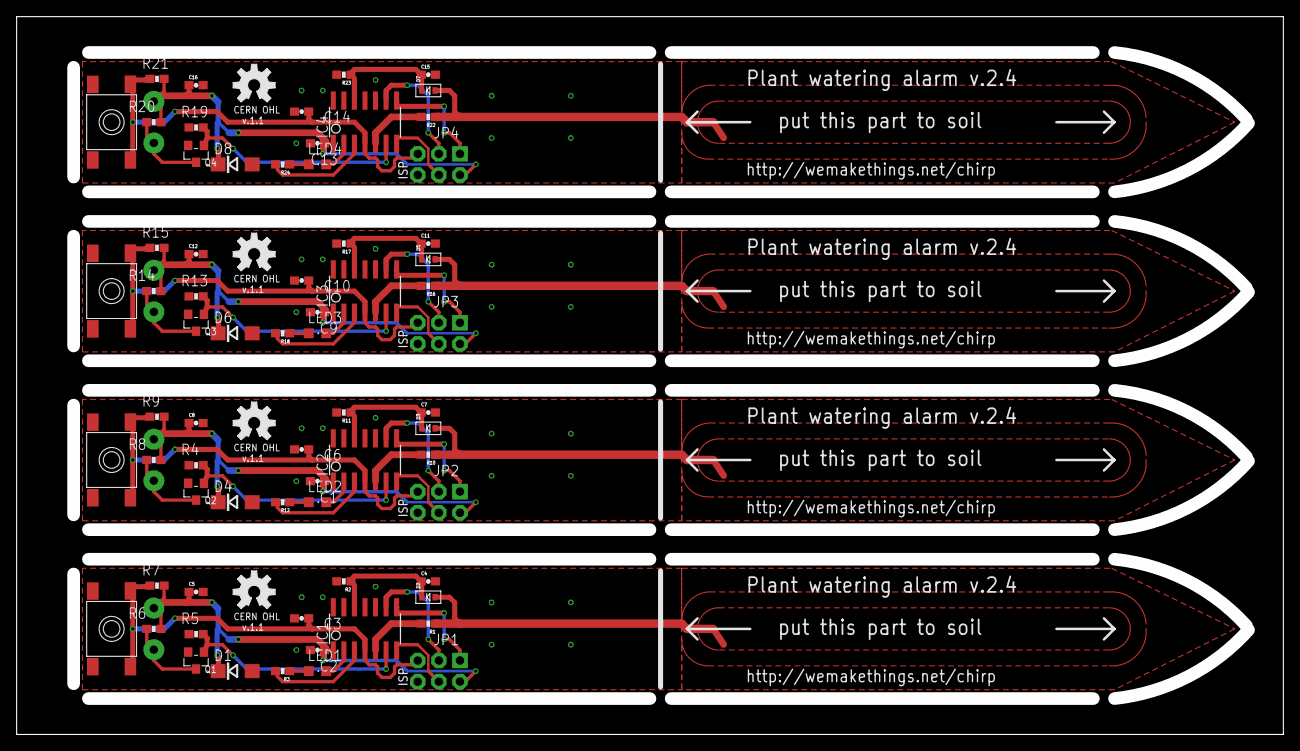
[picture p35: board humidity-v2.4 panel.brd from above]

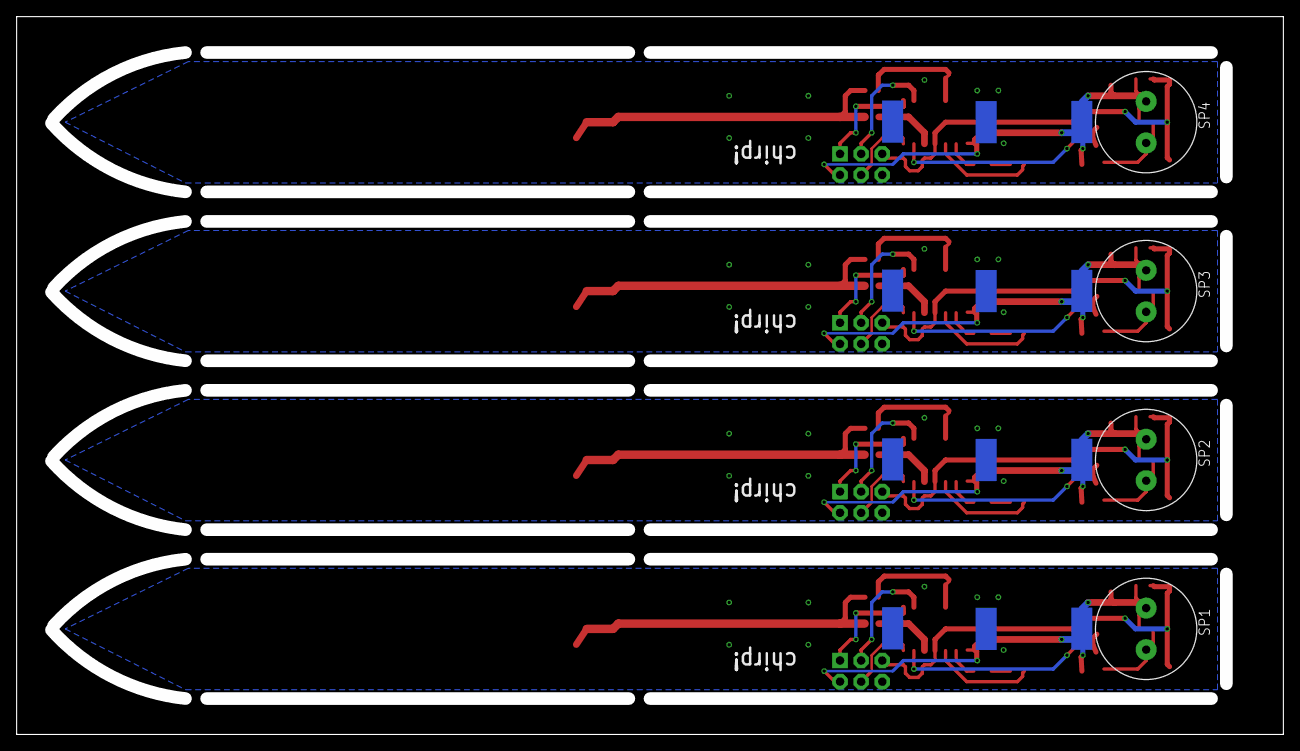
[picture p36: board humidity-v2.4 panel.brd from below]

Board: 2 copper layers, 152.4 x 86.4 mm, 76 parts (8 on the bottom side), 56 nets.

Parts:
B1, B2, B3, B4: BAT-HLD-001
C1, C2, C3, C6, C9, C10, C13, C14: 100nF; 0603-CAP
C4, C5, C7, C8, C11, C12, C15, C16: 1uF; 0603-CAP
D1, D4, D6, D8: DO214AC
D2, D3, D5, D7: DIODE-SCHOTTKY_; SOD-523
IC1, IC2, IC3, IC4: TINY24/44/84-SSU; SOIC14
JP1, JP2, JP3, JP4: AVR_SPI_PRG_6NS; 2X3-NS
LED1, LED2, LED3, LED4: CHIPLED_0805
Q1, Q2, Q3, Q4: SOT23
R1, R4, R5, R7, R9, R10, R13, R15, R16, R19, R21, R22: 10K; 0603-RES
R2, R11, R17, R23: 510K; 0603-RES
R3, R12, R18, R24: 100R; 0603-RES
R6, R8, R14, R20: 1K; 0603-RES
SP1, SP2, SP3, SP4: SPEAKER/PS12; PS12
SW1, SW2, SW3, SW4: SPST_TACTFSMJSMA; FSMJSMA

Connections:
BUZZER: IC1.6, Q1.1, R5.2
BUZZER1: IC2.6, Q2.1, R4.2
BUZZER2: IC3.6, Q3.1, R13.2
BUZZER3: IC4.6, Q4.1, R19.2
CAPACITANCE_V: C4.1, D2.K, IC1.12, R2.1
CAPACITANCE_V1: C7.1, D3.K, IC2.12, R11.1
CAPACITANCE_V2: C11.1, D5.K, IC3.12, R17.1
CAPACITANCE_V3: C15.1, D7.K, IC4.12, R23.1
CLK_OUT: IC1.5, R1.2
CLK_OUT1: IC2.5, R10.2
CLK_OUT2: IC3.5, R16.2
CLK_OUT3: IC4.5, R22.2
GND: B1.2, C2.2, C3.2, C4.2, C5.2, D1.A, IC1.14, JP1.6, Q1.2, R2.2, R5.1, SW1.B, SW1.B'
GND1: B2.2, C1.2, C6.2, C7.2, C8.2, D4.A, IC2.14, JP2.6, Q2.2, R4.1, R11.2, SW2.B, SW2.B'
GND2: B3.2, C9.2, C10.2, C11.2, C12.2, D6.A, IC3.14, JP3.6, Q3.2, R13.1, R17.2, SW3.B, SW3.B'
GND3: B4.2, C13.2, C14.2, C15.2, C16.2, D8.A, IC4.14, JP4.6, Q4.2, R19.1, R23.2, SW4.B, SW4.B'
LED_A: IC1.3, R3.2
LED_A1: IC2.3, R12.2
LED_A2: IC3.3, R18.2
LED_A3: IC4.3, R24.2
LED_K: IC1.2, LED1.C
LED_K1: IC2.2, LED2.C
LED_K2: IC3.2, LED3.C
LED_K3: IC4.2, LED4.C
MISO: IC1.8, JP1.1
MISO1: IC2.8, JP2.1
MISO2: IC3.8, JP3.1
MISO3: IC4.8, JP4.1
MOSI: IC1.7, JP1.4
MOSI1: IC2.7, JP2.4
MOSI2: IC3.7, JP3.4
MOSI3: IC4.7, JP4.4
unnamed: Q1.3, R6.1, SP1.P$2
unnamed: LED1.A, R3.1
unnamed: Q2.3, R8.1, SP2.P$2
unnamed: LED2.A, R12.1
unnamed: Q3.3, R14.1, SP3.P$2
unnamed: LED3.A, R18.1
unnamed: Q4.3, R20.1, SP4.P$2
unnamed: LED4.A, R24.1
RESET: C3.1, IC1.4, JP1.5, R7.1, SW1.A, SW1.A'
RESET1: C6.1, IC2.4, JP2.5, R9.1, SW2.A, SW2.A'
RESET2: C10.1, IC3.4, JP3.5, R15.1, SW3.A, SW3.A'
RESET3: C14.1, IC4.4, JP4.5, R21.1, SW4.A, SW4.A'
SCK: IC1.9, JP1.3
SCK1: IC2.9, JP2.3
SCK2: IC3.9, JP3.3
SCK3: IC4.9, JP4.3
VCC: B1.1, C2.1, C5.1, D1.C, IC1.1, JP1.2, R6.2, R7.2, SP1.P$1
VCC1: B2.1, C1.1, C8.1, D4.C, IC2.1, JP2.2, R8.2, R9.2, SP2.P$1
VCC2: B3.1, C9.1, C12.1, D6.C, IC3.1, JP3.2, R14.2, R15.2, SP3.P$1
VCC3: B4.1, C13.1, C16.1, D8.C, IC4.1, JP4.2, R20.2, R21.2, SP4.P$1
V_CAP: D2.A, R1.1
V_CAP1: D3.A, R10.1
V_CAP2: D5.A, R16.1
V_CAP3: D7.A, R22.1
