Miceuz/PlantWateringAlarm/src/programmer/firmware.h

#include <avr/pgmspace.h>
PROGMEM const unsigned int firmware[] = {
0xC010, 0xC01F, 0xC01E, 0xC0F1, 0xC07D, 0xC01B, 0xC01A, 0xC019, 
0xC107, 0xC017, 0xC016, 0xC015, 0xC014, 0xC09C, 0xC012, 0xC2B2, 
0xC2CE, 0x2411, 0xBE1F, 0xE5CF, 0xE0D1, 0xBFDE, 0xBFCD, 0xE010, 
0xE6A0, 0xE0B0, 0xC001, 0x921D, 0x39A2, 0x07B1, 0xF7E1, 0xD1A2, 
0xC381, 0xCFDE, 0xBE10, 0xBE13, 0xB780, 0x6280, 0xBF80, 0xB780, 
0x6081, 0xBF80, 0xB783, 0x6081, 0xBF83, 0x9508, 0xDFF3, 0xE380, 
0xBF8C, 0xE083, 0xE299, 0x9701, 0xF7F1, 0xC000, 0x0000, 0xBE13, 
0x98DF, 0x9508, 0xB387, 0x6083, 0xBB87, 0x98C0, 0x9AC1, 0x9508, 
0xB387, 0x7F8C, 0xBB87, 0xB388, 0x7F8C, 0xBB88, 0x9508, 0x93CF, 
0x93DF, 0x921F, 0xB7CD, 0xB7DE, 0x9802, 0xC00A, 0x8389, 0xDFDE, 
0xE0EF, 0xE2F7, 0x9731, 0xF7F1, 0xC000, 0x0000, 0x8189, 0x5081, 
0x1181, 0xCFF4, 0x9A02, 0x900F, 0x91DF, 0x91CF, 0x9508, 0x9AD8, 
0x98D8, 0x9ADA, 0x98DA, 0x9ADB, 0x98DB, 0x9AD7, 0x98DF, 0x9AB8, 
0x98C0, 0x9AB9, 0x98C1, 0x9ABA, 0x98C2, 0x9508, 0x9A09, 0x9A03, 
0x9A02, 0x9837, 0x9A00, 0x9A01, 0x9508, 0xB581, 0x6180, 0xBD81, 
0xB581, 0x7F87, 0xBD81, 0xB581, 0x6480, 0xBD81, 0xB581, 0x6086, 
0xBD81, 0x9508, 0x921F, 0x920F, 0xB60F, 0x920F, 0x2411, 0x900F, 
0xBE0F, 0x900F, 0x901F, 0x9518, 0xB785, 0x7E87, 0x6180, 0xBF85, 
0xB785, 0x6280, 0xBF85, 0xB785, 0x6884, 0xBF85, 0xB785, 0x7F8B, 
0xBF85, 0x9588, 0xB785, 0x7D8F, 0xBF85, 0x9508, 0xB785, 0x7E87, 
0x6088, 0xBF85, 0xB785, 0x6280, 0xBF85, 0x9588, 0xB785, 0x7D8F, 
0xBF85, 0x9508, 0x921F, 0x920F, 0xB60F, 0x920F, 0x2411, 0x900F, 
0xBE0F, 0x900F, 0x901F, 0x9518, 0xBE16, 0xE482, 0xBF80, 0xE081, 
0xBF83, 0x9508, 0xBE13, 0xBE10, 0x9508, 0x9A32, 0x9A33, 0x9A38, 
0x9A36, 0xDFDC, 0xB124, 0xB135, 0x2F93, 0xE080, 0x2B82, 0xEF2F, 
0xE033, 0x1B28, 0x0B39, 0x01C9, 0x9508, 0x93CF, 0x93DF, 0xD000, 
0xB7CD, 0xB7DE, 0x9800, 0x9A37, 0x9802, 0xDFDE, 0xEF89, 0xE090, 
0x9701, 0xF7F1, 0xC000, 0x0000, 0xDFE0, 0xE39F, 0xE0ED, 0xE0F3, 
0x5091, 0x40E0, 0x40F0, 0xF7E1, 0xC000, 0x0000, 0xDFD6, 0x8389, 
0x839A, 0xDFD0, 0x98C2, 0x9A02, 0x9837, 0x9A00, 0x8189, 0x819A, 
0x900F, 0x900F, 0x91DF, 0x91CF, 0x9508, 0x921F, 0x920F, 0xB60F, 
0x920F, 0x2411, 0x938F, 0x939F, 0xB78B, 0x7D8F, 0xBF8B, 0xBC1E, 
0xB58C, 0xB59D, 0x9390, 0x0067, 0x9380, 0x0066, 0xE081, 0x9380, 
0x0065, 0x919F, 0x918F, 0x900F, 0xBE0F, 0x900F, 0x901F, 0x9518, 
0x921F, 0x920F, 0xB60F, 0x920F, 0x2411, 0x938F, 0x939F, 0xEF8F, 
0xEF9F, 0x9390, 0x0067, 0x9380, 0x0066, 0xE081, 0x9380, 0x0065, 
0x919F, 0x918F, 0x900F, 0xBE0F, 0x900F, 0x901F, 0x9518, 0x9803, 
0x9A60, 0xB387, 0x6083, 0xBB87, 0x98C0, 0x9AC1, 0x9AC0, 0x98C1, 
0x98B8, 0xB388, 0x7F8C, 0xBB88, 0xBC1D, 0xBC1C, 0xBC1F, 0xE084, 
0xBD8E, 0xB580, 0x6081, 0xBD80, 0xB78B, 0x6280, 0xBF8B, 0x9210, 
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

};
#define FIRMWARE_WORD_COUNT  932
