Miceuz/PlantWateringAlarm/(commit log)

2012-08-02 initial board and schematics
    [humidity.brd, humidity.sch]
2012-09-07 +firmware, thicker traces, etc
    [humidity.brd, humidity.sch]
2012-09-16 +power saving
2012-09-29 mainly current test setup code, some power saving directives commented out
2012-09-29 working on v2.1 and v2.2 - low pass filter based setup. various sensor designs for testing
    [capsensor.brd, capsensor2.brd, capsensor24.brd, chirp.skp, chirp2.skp, humidity-v2.1.brd, humidity-v2.1.sch, humidity-v2.2.brd]
2012-10-03 all the v2.2 changes + light sensor
2012-10-23 v2.3 ordered from seeed
    [humidity-v2.3.brd, humidity-v2.3.sch]
2012-11-28 final touches before production
    [bom.csv, chirp v.2.3.skp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]
2012-12-05 minor spelling fixes
    [bom.csv]
2012-12-05 moved the insertion line a bit further, moved components away from the soil, made a new order at seeed
    [humidity-v2.3.1 panelized.GBL, humidity-v2.3.1 panelized.GBO, humidity-v2.3.1 panelized.GBP, humidity-v2.3.1 panelized.GBS, humidity-v2.3.1 panelized.GTL, humidity-v2.3.1 panelized.GTO, humidity-v2.3.1 panelized.GTP, humidity-v2.3.1 panelized.GTS]
2013-06-10 change SPI to I2C
2013-06-10 USI driver
2013-06-10 add schematics pic for eagle free people
2013-07-14 add twi driver to makefile
2013-07-14 fix thresholds, tune up sensor mode
    [main.c]
2013-10-27 a new board design
2014-01-17 schematics png updated
2014-02-17 Don't switch OSC speed as it cretes problems in sensor mode. Run everything at 2Mhz. Chirp sound has changed, but oh well. Turn the thresholds all the way down. For plants that are watered more often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
    [main.c]
2014-02-17 put direcotry in to some order
    [capsensor.brd, capsensor2.brd, capsensor24.brd, chirp-v2.4.brd, chirp-v2.4.sch, humidity-v2.1.brd, humidity-v2.1.sch, humidity-v2.2.brd]
2014-02-19 leave led connected to ground while discharging
2014-02-19 schematics in b/w
2014-05-17 v-scoring instead of routing
    [chirp-v2.4.brd]
2014-11-23 erase eeprom while flashing, allow eeprom erasing in fuses
2014-11-23 on the first startup expect full darkness and calibrate to that, save light threshold to eeprom
2015-12-13 Move Chirp layout to KiCad. Finally.
    [chirp-v2.4-pannel-B_Cu.gbr, chirp-v2.4-pannel-B_Mask.gbr, chirp-v2.4-pannel-B_SilkS.gbr, chirp-v2.4-pannel-Edge_Cuts.gbr, chirp-v2.4-pannel-F_Cu.gbr, chirp-v2.4-pannel-F_Mask.gbr, chirp-v2.4-pannel-F_SilkS.gbr, chirp-v2.4-pannel.drl]
2016-02-23 Add manufacturing set, tune up the silkscreen on the board
    [chirp-bom.xlsx, chirp-v2.4.kicad_pcb]
2017-08-30 Fix inline function declarations, preserve eeprom upon flashing
    [main.c]
2018-03-13 Shorten the measurement time as we change the capacitor to a smaller one. Avoid ADC sleep as it stops the excitation timer
    [main.c]
2018-03-22 Erase eeprom on reflash. Blink led before chirping
2019-02-23 Prohibit setting i2c addresses > 127
    i2c addresses are 7 bits, where the 8th bit is reserved by the protocol to indicate whether reading or writing is intended.
