Miceuz/PlantWateringAlarm/(notices)

Notices in the files:
src/usiTwiSlave.c:
This program is free software; you can redistribute it and/or modify it under the
terms of the GNU General Public License as published by the Free Software
gerbers/humidity-v2.4 panel.brd:
CERN OHL
